PUT-Motorsport/PUTM_EV_IMD_SAFETY_2022/README.md

# PUTM_EV_IMD_SAFETY_2022
Board for handling Bender Insulation Measuring Device, enabling openig shutdown circuit in case of Trackive System potencial shortening to LV ground
