PUT-Motorsport/PUTM_EV_IMD_SAFETY_2022/PUTM_EV_IMD_SAFETY_2021.kicad_pcb

## KiCad design PUTM_EV_IMD_SAFETY_2021.kicad_pcb (2022-08-01)

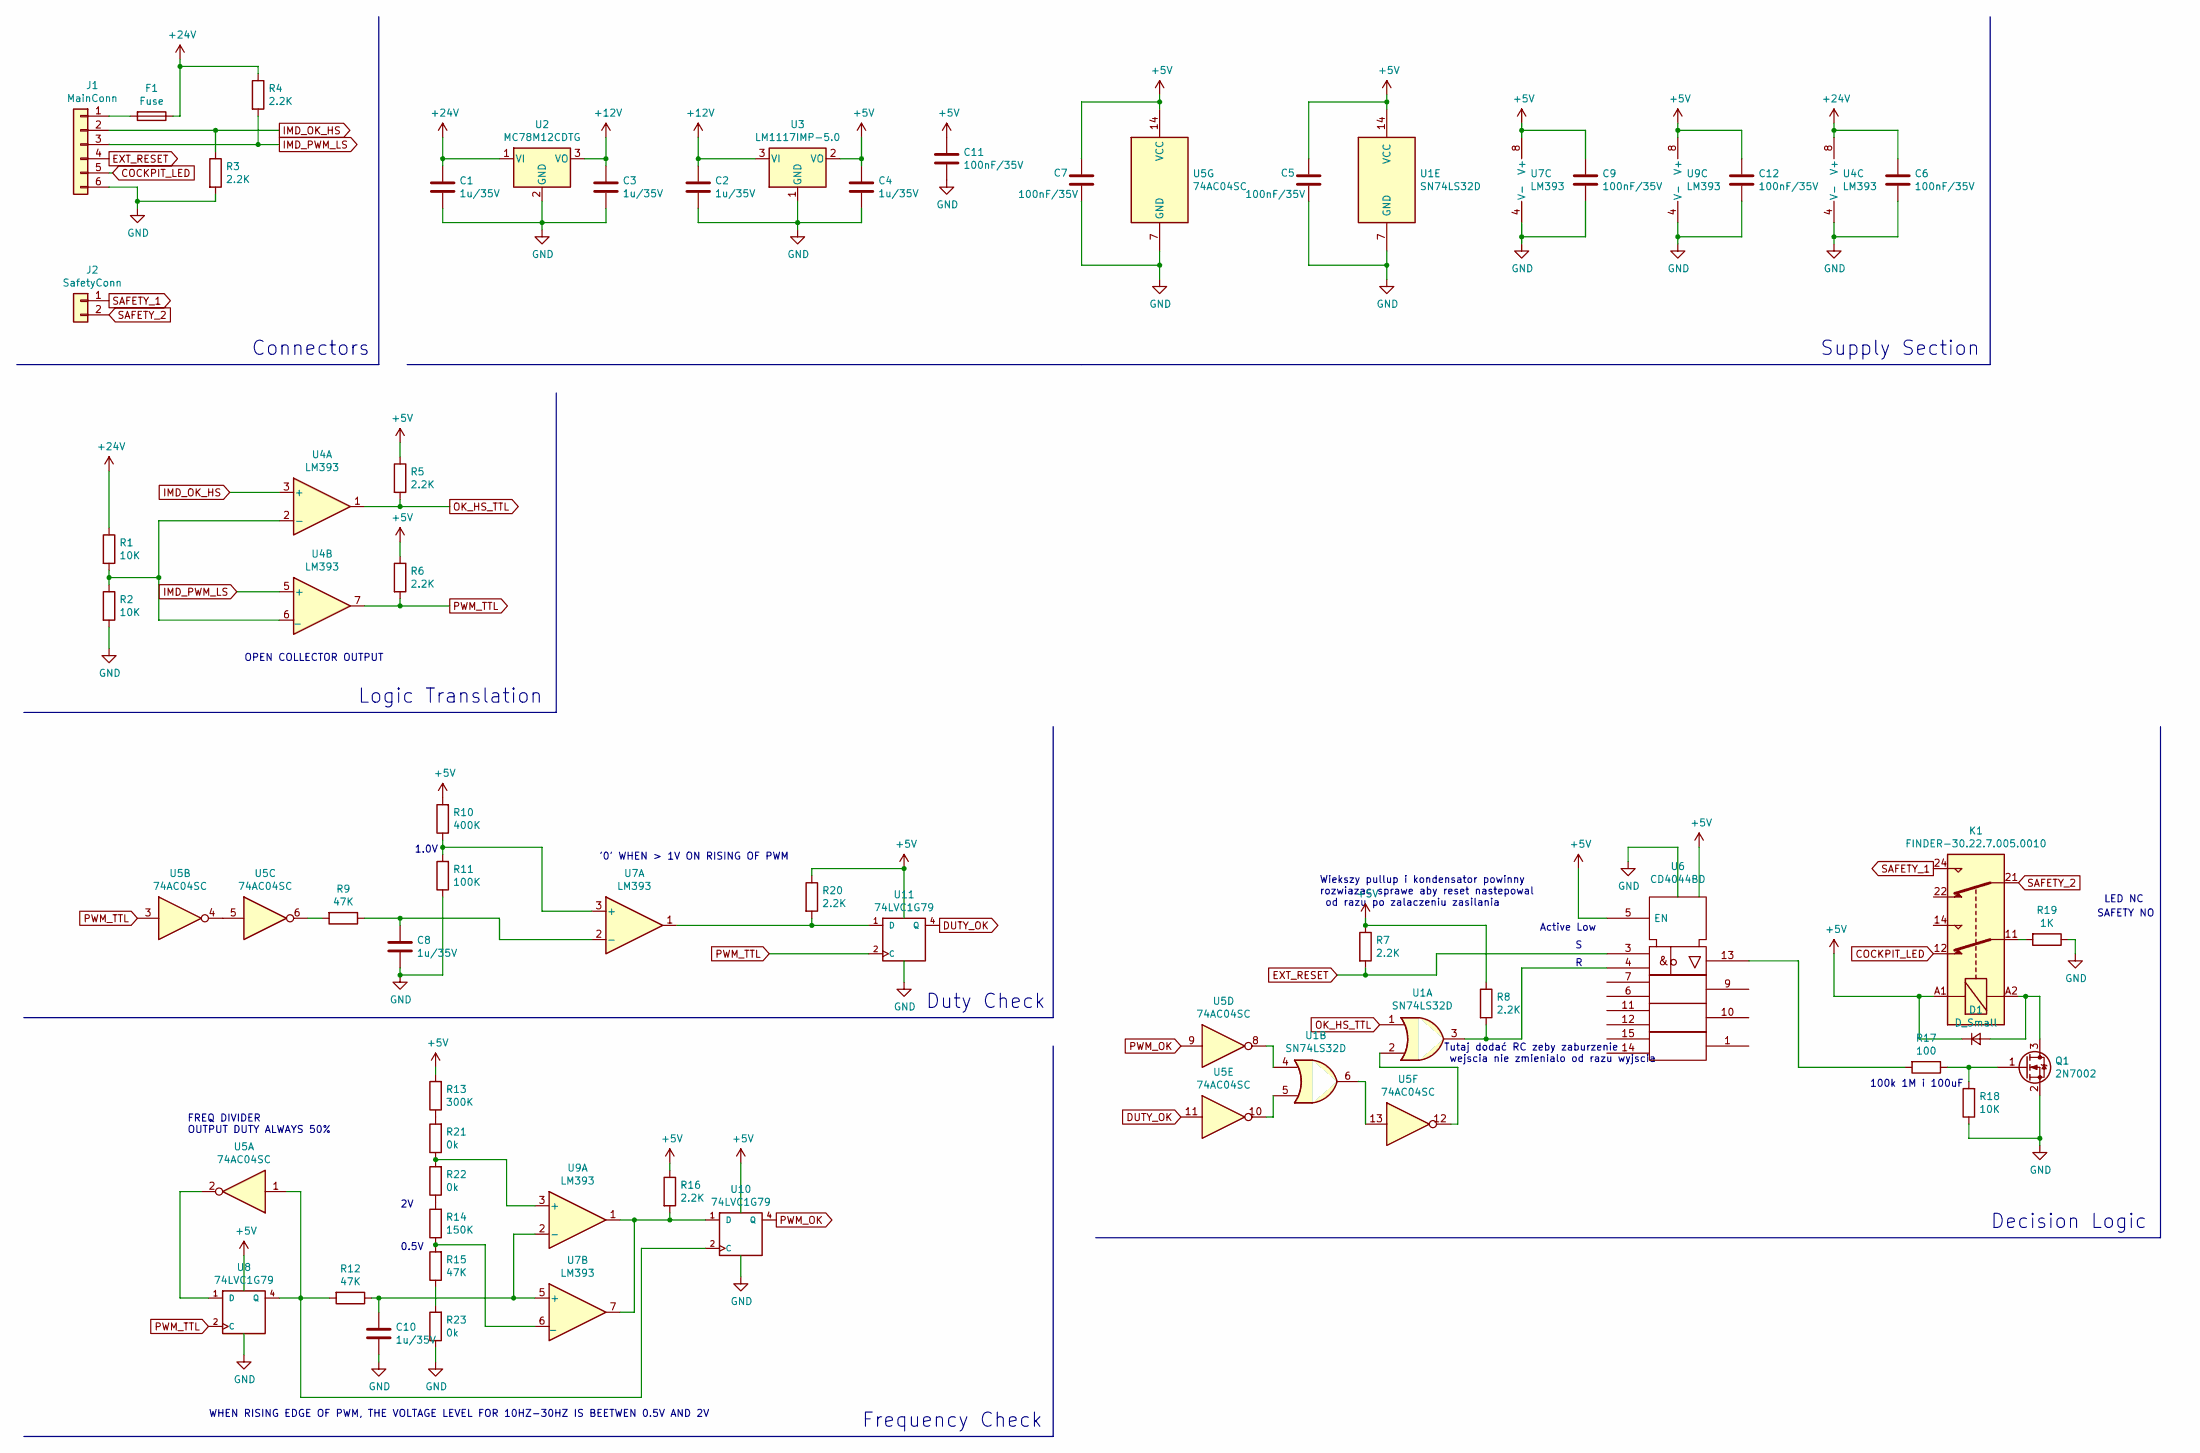
[picture p1: schematic PUTM_EV_IMD_SAFETY_2021.kicad_sch, IMD safety]

Parts:
C1, C2, C3, C4, C8, C10: 1u/35V; C_1206_3216Metric
C5, C6, C7, C9, C11, C12: 100nF/35V; C_1206_3216Metric
D1: D_Small; D_SMB
F1: Fuse; Fuse_1812_4532Metric
J1: MainConn; Molex_Micro-Fit_3.0_43650-0600_1x06_P3.00mm_Horizontal
J2: SafetyConn; Molex_Micro-Fit_3.0_43650-0200_1x02_P3.00mm_Horizontal
K1: FINDER-30.22.7.005.0010; Relay_DPDT_Finder_30.22
Q1: 2N7002; SOT-23
R1, R2, R18: 10K; R_1206_3216Metric
R3, R4, R5, R6, R7, R8, R16, R20: 2.2K; R_1206_3216Metric
R9, R12, R15: 47K; R_1206_3216Metric
R10: 400K; R_1206_3216Metric
R11: 100K; R_1206_3216Metric
R13: 300K; R_1206_3216Metric
R14: 150K; R_1206_3216Metric
R17: 100; R_1206_3216Metric
R19: 1K; R_1206_3216Metric
R21, R22, R23: 0k; R_1206_3216Metric
U1: SN74LS32D; SOIC-14_3.9x8.7mm_P1.27mm
U2: MC78M12CDTG; TO-252-3_TabPin2
U3: LM1117IMP-5.0; SOT-223-3_TabPin2
U4, U7, U9: LM393; SO-8_3.9x4.9mm_P1.27mm
U5: 74AC04SC; SOIC-14_3.9x8.7mm_P1.27mm
U6: CD4044BD; SOP-16_4.55x10.3mm_P1.27mm
U8, U10, U11: 74LVC1G79; SOT-23-5

Connections:
+5V: C4.1, C5.1, C7.1, C9.1, C11.1, C12.1, D1.1 (K), K1.A1, R5.1, R6.1, R7.1, R8.1, R10.2, R13.2, R16.1, R20.1, U1.14 (VCC), U3.2 (VO), U5.14 (VCC), U6.5 (EN), U6.16 (Vdd), U7.8 (V+), U8.5 (VCC), U9.8 (V+), U10.5 (VCC), U11.5 (VCC)
+12V: C2.1, C3.1, U2.3 (VO), U3.3 (VI)
+24V: C1.1, C6.1, F1.1, R1.1, R4.1, U2.1 (VI), U4.8 (V+)
COCKPIT_LED: J1.5, K1.12
DUTY_OK: U5.11, U11.4 (Q)
EXT_RESET: J1.4, R7.2, U6.3
GND: C1.2, C2.2, C3.2, C4.2, C5.2, C6.2, C7.2, C8.2, C9.2, C10.2, C11.2, C12.2, J1.6, Q1.2 (S), R2.2, R3.2, R11.1, R18.1, R19.1, R23.1, U1.7 (GND), U2.2 (GND), U3.1 (GND), U4.4 (V-), U5.7 (GND), U6.8 (Vss), U7.4 (V-), U8.3 (GND), U9.4 (V-), U10.3 (GND), U11.3 (GND)
IMD_OK_HS: J1.2, R3.1, U4.3 (+)
IMD_PWM_LS: J1.3, R4.2, U4.5 (+)
unnamed: C8.1, R9.1, U7.2 (-)
unnamed: C10.1, R12.1, U7.5 (+), U9.2 (-)
unnamed: D1.2 (A), K1.A2, Q1.3 (D)
unnamed: F1.2, J1.1
unnamed: K1.11, R19.2
unnamed: Q1.1 (G), R17.1, R18.2
unnamed: R1.2, R2.1, U4.2 (-), U4.6 (_)
unnamed: R8.2, U1.3, U6.4
unnamed: R9.2, U5.6
unnamed: R10.1, R11.2, U7.3 (+)
unnamed: R12.2, U5.1, U8.4 (Q), U10.2 (C)
unnamed: R13.1, R21.2
unnamed: R14.1, R15.2, U7.6 (_)
unnamed: R14.2, R22.1
unnamed: R15.1, R23.2
unnamed: R16.2, U7.7, U9.1, U10.1 (D)
unnamed: R17.2, U6.13
unnamed: R20.2, U7.1, U11.1 (D)
unnamed: R21.1, R22.2, U9.3 (+)
unnamed: U1.2, U5.12
unnamed: U1.4, U5.8
unnamed: U1.5, U5.10
unnamed: U1.6, U5.13
unnamed: U5.2, U8.1 (D)
unnamed: U5.4, U5.5
OK_HS_TTL: R5.2, U1.1, U4.1
PWM_OK: U5.9, U10.4 (Q)
PWM_TTL: R6.2, U4.7, U5.3, U8.2 (C), U11.2 (C)
SAFETY_1: J2.1, K1.24
SAFETY_2: J2.2, K1.21

Notes on the sheet:
Active Low
Wiekszy pullup i kondensator powinny rozwiazac sprawe aby reset nastepowal od razu po zalaczeniu zasilania
Decision Logic
Supply Section
Tutaj dodać RC zeby zaburzenie wejscia nie zmienialo od razu wyjscia
LED NC
Frequency Check
OPEN COLLECTOR OUTPUT
FREQ DIVIDER OUTPUT DUTY ALWAYS 50%
100k 1M i 100uF
0.5V
SAFETY NO
'0' WHEN > 1V ON RISING OF PWM
Connectors
Duty Check
Logic Translation
1.0V
WHEN RISING EDGE OF PWM, THE VOLTAGE LEVEL FOR 10HZ-30HZ IS BEETWEN 0.5V AND 2V

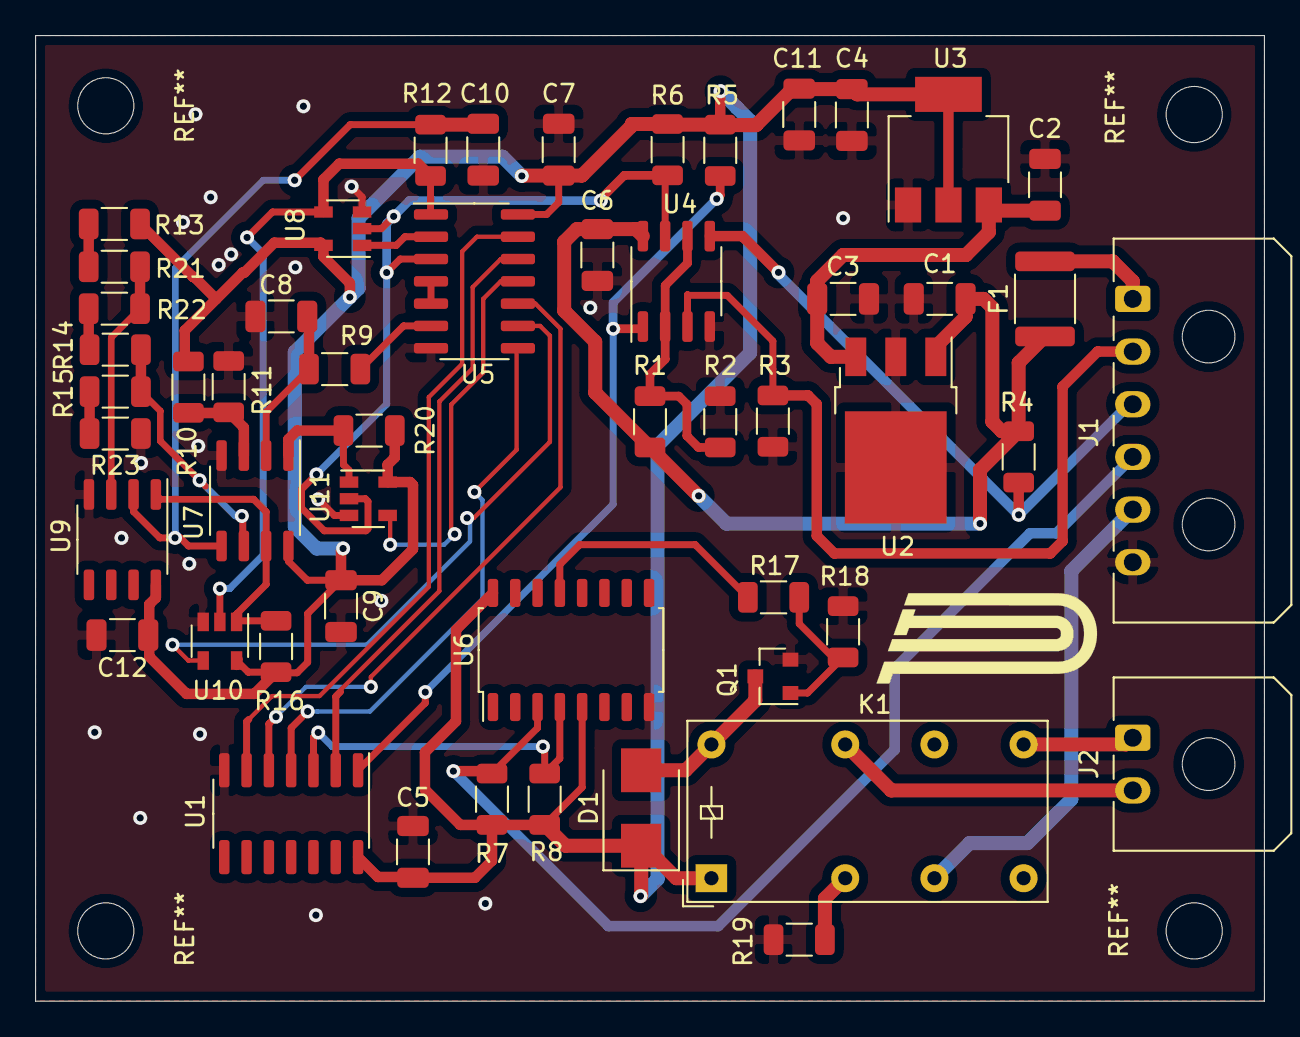
[picture p2: board PUTM_EV_IMD_SAFETY_2021.kicad_pcb from above]

Board: 2 copper layers, 70.0 x 55.0 mm, 52 parts (0 on the bottom side), 39 nets.
