PUT-Motorsport/PUTM_EV_IMD_SAFETY_2022/(commit log)

2022-03-08 Transfer from Podio
    [PUTM_EV_IMD_SAFETY_2021.kicad_pcb, PUTM_EV_IMD_SAFETY_2021.sch]
2022-06-04 schematic edited - changed comparator ladder connections
    [PUTM_EV_IMD_SAFETY_2021.sch]
2022-06-04 PCB Routed and signed with v2 version
    [PUTM_EV_IMD_SAFETY_2021.kicad_pcb]
2022-08-01 Project converted to Kicad6, Schematic beatuyfing
    [PUTM_EV_IMD_SAFETY_2021.kicad_pcb, PUTM_EV_IMD_SAFETY_2021.kicad_sch, PUTM_EV_IMD_SAFETY_2021.sch]
2022-08-01 Added autoreset into schematic
    [PUTM_EV_IMD_SAFETY_2021.kicad_sch]
2022-08-01 Schematic upgraded with hard wired componets
    [PUTM_EV_IMD_SAFETY_2021.kicad_sch]
2022-08-01 Schematic patch
    [PUTM_EV_IMD_SAFETY_2021.kicad_sch]
2022-08-01 changes of schematic components values
    [PUTM_EV_IMD_SAFETY_2021.kicad_sch]
